grahamwhaley/DSPham/(threads)

Thread 1 (2021-02-15):

FIR filter co-efficients are 'non-optimal' - may need 'normalisation'

grahamwhaley, 2021-02-15:
Whilst working on some other experimentation, I noticed that the auto-generated FIR filter co-efficients for the bandpass filters seem to introduce a lot of attenuation, and are probably not 'optimal' for the required operation. That is no real surprise, as they are generated by a quick dynamic piece of code, and calculating optimal FIR coefficients is compute intensive.

The FIR filters happen early in the chain, which means later stages are probably not getting as 'full' a bitwidth signal as they should. This probably affects their performance.

I have some experimental code already that tries to measure the gain of the coefficients at their 'centre peak' intended frequency. Let's see if that improves anything.

(If you want to look at this etc., probably best ask me first so we don't duplicate)

Closed 2021-02-16.

Thread 2 (2021-02-16):

Decimate audio to improve NR

grahamwhaley, 2021-02-16:
Some of the NR reduction algos, such as the Spectral (possibly the best one), work on 'bins', splitting the audio into 'bins' and then selecting which ones have audio in them or not etc.
Currently (v1.0) we run the audio path at a full 44kHz sample rate, which is 'wasteful', as we are normally only interested in the audio part, which is probably upto 3.5kHz max.

If we decimate the audio path by 4, that takes us down to ~11kHz, so an audio bandwidth of ~5.5kHz. That will still leave us with plenty of 'space' for normal audio, and even an OK bandwidth for AM SWL. It will hopefully allow the NR systems to 'focus' more finely on the actual audio, and thus hopefully do an even better job of sorting out the noise from the useful sounds.

Try it out...

Closed 2021-02-16.

Thread 5 (2021-02-18):

Compiling DSPham.ini

codehopper199, 2021-02-18:
Hello Graham,
Very interested in your Radcom article as I have been trying to improve the audio on my IC7300 to get rid of some of noise on the output. I am not a programmer so could do with a bit of help if that is possible.
I am trying to compile DSPham.ino but it fails every time. I believe I have all the necessary files within my arduino IDE but it always comes back with an error as below where it cannot find global.h
Any help would be much appreciated.
Rod G0IYQ

Arduino: 1.8.13 (Windows 10), TD: 1.53, Board: "Teensy 4.0, Serial, 600 MHz, Faster, US English"

C:\Program Files (x86)\Arduino\arduino-builder -dump-prefs -logger=machine -hardware C:\Program Files (x86)\Arduino\hardware -tools C:\Program Files (x86)\Arduino\tools-builder -tools C:\Program Files (x86)\Arduino\hardware\tools\avr -built-in-libraries C:\Program Files (x86)\Arduino\libraries -libraries C:\Users\rodmi\Documents\Arduino\libraries -fqbn=teensy:avr:teensy40:usb=serial,speed=600,opt=o2std,keys=en-us -ide-version=10813 -build-path C:\Users\rodmi\AppData\Local\Temp\arduino_build_958171 -warnings=none -build-cache C:\Users\rodmi\AppData\Local\Temp\arduino_cache_775077 -verbose C:\Users\rodmi\AppData\Local\Temp\untitled2054921278.tmp\sketch_feb18a\sketch_feb18a.ino

C:\Program Files (x86)\Arduino\arduino-builder -compile -logger=machine -hardware C:\Program Files (x86)\Arduino\hardware -tools C:\Program Files (x86)\Arduino\tools-builder -tools C:\Program Files (x86)\Arduino\hardware\tools\avr -built-in-libraries C:\Program Files (x86)\Arduino\libraries -libraries C:\Users\rodmi\Documents\Arduino\libraries -fqbn=teensy:avr:teensy40:usb=serial,speed=600,opt=o2std,keys=en-us -ide-version=10813 -build-path C:\Users\rodmi\AppData\Local\Temp\arduino_build_958171 -warnings=none -build-cache C:\Users\rodmi\AppData\Local\Temp\arduino_cache_775077 -verbose C:\Users\rodmi\AppData\Local\Temp\untitled2054921278.tmp\sketch_feb18a\sketch_feb18a.ino

Using board 'teensy40' from platform in folder: C:\Program Files (x86)\Arduino\hardware\teensy\avr

Using core 'teensy4' from platform in folder: C:\Program Files (x86)\Arduino\hardware\teensy\avr

Detecting libraries used...

"C:\\Program Files (x86)\\Arduino\\hardware\\teensy/../tools/arm/bin/arm-none-eabi-g++" -E -CC -x c++ -w -g -Wall -ffunction-sections -fdata-sections -nostdlib -std=gnu++14 -fno-exceptions -fpermissive -fno-rtti -fno-threadsafe-statics -felide-constructors -Wno-error=narrowing -mthumb -mcpu=cortex-m7 -mfloat-abi=hard -mfpu=fpv5-d16 -D__IMXRT1062__ -DTEENSYDUINO=153 -DARDUINO=10813 -DARDUINO_TEENSY40 -DF_CPU=600000000 -DUSB_SERIAL -DLAYOUT_US_ENGLISH "-IC:\\Program Files (x86)\\Arduino\\hardware\\teensy\\avr\\cores\\teensy4" "C:\\Users\\rodmi\\AppData\\Local\\Temp\\arduino_build_958171\\sketch\\sketch_feb18a.ino.cpp" -o nul -DARDUINO_LIB_DISCOVERY_PHASE

Alternatives for Audio.h: [Audio@1.3]

ResolveLibrary(Audio.h)

  -> candidates: [Audio@1.3]

"C:\\Program Files (x86)\\Arduino\\hardware\\teensy/../tools/arm/bin/arm-none-eabi-g++" -E -CC -x c++ -w -g -Wall -ffunction-sections -fdata-sections -nostdlib -std=gnu++14 -fno-exceptions -fpermissive -fno-rtti -fno-threadsafe-statics -felide-constructors -Wno-error=narrowing -mthumb -mcpu=cortex-m7 -mfloat-abi=hard -mfpu=fpv5-d16 -D__IMXRT1062__ -DTEENSYDUINO=153 -DARDUINO=10813 -DARDUINO_TEENSY40 -DF_CPU=600000000 -DUSB_SERIAL -DLAYOUT_US_ENGLISH "-IC:\\Program Files (x86)\\Arduino\\hardware\\teensy\\avr\\cores\\teensy4" "-IC:\\Program Files (x86)\\Arduino\\hardware\\teensy\\avr\\libraries\\Audio" "C:\\Users\\rodmi\\AppData\\Local\\Temp\\arduino_build_958171\\sketch\\sketch_feb18a.ino.cpp" -o nul -DARDUINO_LIB_DISCOVERY_PHASE

Alternatives for SPI.h: [SPI@1.0]

ResolveLibrary(SPI.h)

  -> candidates: [SPI@1.0]

"C:\\Program Files (x86)\\Arduino\\hardware\\teensy/../tools/arm/bin/arm-none-eabi-g++" -E -CC -x c++ -w -g -Wall -ffunction-sections -fdata-sections -nostdlib -std=gnu++14 -fno-exceptions -fpermissive -fno-rtti -fno-threadsafe-statics -felide-constructors -Wno-error=narrowing -mthumb -mcpu=cortex-m7 -mfloat-abi=hard -mfpu=fpv5-d16 -D__IMXRT1062__ -DTEENSYDUINO=153 -DARDUINO=10813 -DARDUINO_TEENSY40 -DF_CPU=600000000 -DUSB_SERIAL -DLAYOUT_US_ENGLISH "-IC:\\Program Files (x86)\\Arduino\\hardware\\teensy\\avr\\cores\\teensy4" "-IC:\\Program Files (x86)\\Arduino\\hardware\\teensy\\avr\\libraries\\Audio" "-IC:\\Program Files (x86)\\Arduino\\hardware\\teensy\\avr\\libraries\\SPI" "C:\\Users\\rodmi\\AppData\\Local\\Temp\\arduino_build_958171\\sketch\\sketch_feb18a.ino.cpp" -o nul -DARDUINO_LIB_DISCOVERY_PHASE

Alternatives for SD.h: [SD@1.2.4 SD@1.2.2]

ResolveLibrary(SD.h)

  -> candidates: [SD@1.2.4 SD@1.2.2]

"C:\\Program Files (x86)\\Arduino\\hardware\\teensy/../tools/arm/bin/arm-none-eabi-g++" -E -CC -x c++ -w -g -Wall -ffunction-sections -fdata-sections -nostdlib -std=gnu++14 -fno-exceptions -fpermissive -fno-rtti -fno-threadsafe-statics -felide-constructors -Wno-error=narrowing -mthumb -mcpu=cortex-m7 -mfloat-abi=hard -mfpu=fpv5-d16 -D__IMXRT1062__ -DTEENSYDUINO=153 -DARDUINO=10813 -DARDUINO_TEENSY40 -DF_CPU=600000000 -DUSB_SERIAL -DLAYOUT_US_ENGLISH "-IC:\\Program Files (x86)\\Arduino\\hardware\\teensy\\avr\\cores\\teensy4" "-IC:\\Program Files (x86)\\Arduino\\hardware\\teensy\\avr\\libraries\\Audio" "-IC:\\Program Files (x86)\\Arduino\\hardware\\teensy\\avr\\libraries\\SPI" "-IC:\\Program Files (x86)\\Arduino\\hardware\\teensy\\avr\\libraries\\SD" "C:\\Users\\rodmi\\AppData\\Local\\Temp\\arduino_build_958171\\sketch\\sketch_feb18a.ino.cpp" -o nul -DARDUINO_LIB_DISCOVERY_PHASE

Alternatives for SerialFlash.h: [SerialFlash@0.5]

ResolveLibrary(SerialFlash.h)

  -> candidates: [SerialFlash@0.5]

"C:\\Program Files (x86)\\Arduino\\hardware\\teensy/../tools/arm/bin/arm-none-eabi-g++" -E -CC -x c++ -w -g -Wall -ffunction-sections -fdata-sections -nostdlib -std=gnu++14 -fno-exceptions -fpermissive -fno-rtti -fno-threadsafe-statics -felide-constructors -Wno-error=narrowing -mthumb -mcpu=cortex-m7 -mfloat-abi=hard -mfpu=fpv5-d16 -D__IMXRT1062__ -DTEENSYDUINO=153 -DARDUINO=10813 -DARDUINO_TEENSY40 -DF_CPU=600000000 -DUSB_SERIAL -DLAYOUT_US_ENGLISH "-IC:\\Program Files (x86)\\Arduino\\hardware\\teensy\\avr\\cores\\teensy4" "-IC:\\Program Files (x86)\\Arduino\\hardware\\teensy\\avr\\libraries\\Audio" "-IC:\\Program Files (x86)\\Arduino\\hardware\\teensy\\avr\\libraries\\SPI" "-IC:\\Program Files (x86)\\Arduino\\hardware\\teensy\\avr\\libraries\\SD" "-IC:\\Program Files (x86)\\Arduino\\hardware\\teensy\\avr\\libraries\\SerialFlash" "C:\\Users\\rodmi\\AppData\\Local\\Temp\\arduino_build_958171\\sketch\\sketch_feb18a.ino.cpp" -o nul -DARDUINO_LIB_DISCOVERY_PHASE

Alternatives for Wire.h: [Wire@1.0]

ResolveLibrary(Wire.h)

  -> candidates: [Wire@1.0]

"C:\\Program Files (x86)\\Arduino\\hardware\\teensy/../tools/arm/bin/arm-none-eabi-g++" -E -CC -x c++ -w -g -Wall -ffunction-sections -fdata-sections -nostdlib -std=gnu++14 -fno-exceptions -fpermissive -fno-rtti -fno-threadsafe-statics -felide-constructors -Wno-error=narrowing -mthumb -mcpu=cortex-m7 -mfloat-abi=hard -mfpu=fpv5-d16 -D__IMXRT1062__ -DTEENSYDUINO=153 -DARDUINO=10813 -DARDUINO_TEENSY40 -DF_CPU=600000000 -DUSB_SERIAL -DLAYOUT_US_ENGLISH "-IC:\\Program Files (x86)\\Arduino\\hardware\\teensy\\avr\\cores\\teensy4" "-IC:\\Program Files (x86)\\Arduino\\hardware\\teensy\\avr\\libraries\\Audio" "-IC:\\Program Files (x86)\\Arduino\\hardware\\teensy\\avr\\libraries\\SPI" "-IC:\\Program Files (x86)\\Arduino\\hardware\\teensy\\avr\\libraries\\SD" "-IC:\\Program Files (x86)\\Arduino\\hardware\\teensy\\avr\\libraries\\SerialFlash" "-IC:\\Program Files (x86)\\Arduino\\hardware\\teensy\\avr\\libraries\\Wire" "C:\\Users\\rodmi\\AppData\\Local\\Temp\\arduino_build_958171\\sketch\\sketch_feb18a.ino.cpp" -o nul -DARDUINO_LIB_DISCOVERY_PHASE

Alternatives for Encoder.h: [Encoder@1.4.1]

ResolveLibrary(Encoder.h)

  -> candidates: [Encoder@1.4.1]

"C:\\Program Files (x86)\\Arduino\\hardware\\teensy/../tools/arm/bin/arm-none-eabi-g++" -E -CC -x c++ -w -g -Wall -ffunction-sections -fdata-sections -nostdlib -std=gnu++14 -fno-exceptions -fpermissive -fno-rtti -fno-threadsafe-statics -felide-constructors -Wno-error=narrowing -mthumb -mcpu=cortex-m7 -mfloat-abi=hard -mfpu=fpv5-d16 -D__IMXRT1062__ -DTEENSYDUINO=153 -DARDUINO=10813 -DARDUINO_TEENSY40 -DF_CPU=600000000 -DUSB_SERIAL -DLAYOUT_US_ENGLISH "-IC:\\Program Files (x86)\\Arduino\\hardware\\teensy\\avr\\cores\\teensy4" "-IC:\\Program Files (x86)\\Arduino\\hardware\\teensy\\avr\\libraries\\Audio" "-IC:\\Program Files (x86)\\Arduino\\hardware\\teensy\\avr\\libraries\\SPI" "-IC:\\Program Files (x86)\\Arduino\\hardware\\teensy\\avr\\libraries\\SD" "-IC:\\Program Files (x86)\\Arduino\\hardware\\teensy\\avr\\libraries\\SerialFlash" "-IC:\\Program Files (x86)\\Arduino\\hardware\\teensy\\avr\\libraries\\Wire" "-IC:\\Program Files (x86)\\Arduino\\hardware\\teensy\\avr\\libraries\\Encoder" "C:\\Users\\rodmi\\AppData\\Local\\Temp\\arduino_build_958171\\sketch\\sketch_feb18a.ino.cpp" -o nul -DARDUINO_LIB_DISCOVERY_PHASE

Alternatives for global.h: []

ResolveLibrary(global.h)C:\Users\rodmi\AppData\Local\Temp\untitled2054921278.tmp\sketch_feb18a\DSPham.ino:7:20: fatal error: global.h: No such file or directory

  -> candidates: []

compilation terminated.

Multiple libraries were found for "SD.h"

 Used: C:\Program Files (x86)\Arduino\hardware\teensy\avr\libraries\SD

 Not used: C:\Program Files (x86)\Arduino\libraries\SD

Using library Audio at version 1.3 in folder: C:\Program Files (x86)\Arduino\hardware\teensy\avr\libraries\Audio

Using library SPI at version 1.0 in folder: C:\Program Files (x86)\Arduino\hardware\teensy\avr\libraries\SPI

Using library SD at version 1.2.2 in folder: C:\Program Files (x86)\Arduino\hardware\teensy\avr\libraries\SD

Using library SerialFlash at version 0.5 in folder: C:\Program Files (x86)\Arduino\hardware\teensy\avr\libraries\SerialFlash

Using library Wire at version 1.0 in folder: C:\Program Files (x86)\Arduino\hardware\teensy\avr\libraries\Wire

Using library Encoder at version 1.4.1 in folder: C:\Program Files (x86)\Arduino\hardware\teensy\avr\libraries\Encoder

Error compiling for board Teensy 4.0.

grahamwhaley, 2021-02-19:
Hi Rod,
 thanks for opening the Issue. Nothing obvious leaps out at me, but I'll note a few things and we can try and work our way through it.

First, it looks like you are building on Windows. That should be fine, but I'll note that I build on Linux, and don't have a Windows machine to test on. I'm hoping that is not the problem.

The two primary things I'd expect to be candidates for the problem would be:
 - paths
 - capitalisation

Can I ask, how did you copy the files from github, and what path have you placed them in on your computer? You pretty much need all the files in the top level directory. By far the best way to get the files is by `git` cloning the repository - there are github instructions [here](https://docs.github.com/en/github/creating-cloning-and-archiving-repositories/cloning-a-repository).  Alternatively, you can I believe grab a zip or tar.gz file of one of the tags from https://github.com/grahamwhaley/DSPham/tags, and unzip that locally on your machine.

Make sure your code is in a directory with the same name as the `.ino` file - so `DSPham` in this case. If not then I suspect the Arduino IDE would not even have opened the `.ino` though, so that probably is not your problem.

Let me know how you grabbed the code and where it is placed (maybe a `pwd` and an `dir` to show the contents), and we'll go from there.

grahamwhaley, 2021-02-19:
Small update - I just grabbed the `.tar.gz` from the v1.0 tag. I found that it unzipped into a folder called `DSPham-1.0` (gee, thanks github ;-) ). That has to be renamed to plain `DSPham` in order to then work in the IDE.

grahamwhaley, 2021-02-20:
Hi @codehopper199 - re: our recent email thread, I think you are now building OK, yes?

To summarise, the key items we found were:
 - github zip/tar files place the project in a `DSPham-xxx` folder, but to build in the Arduino IDE the files *must* be in a folder called just `DSPham`
 - The Teensy board config in the Arduino IDE must be set to include the 'Audio' component - I use `Serial+MIDI+Audio`, so I'd generally recommend that.

Correct?

I've got a documentation change ready to merge detailing the first point. Let me know if you are OK with building now, and I'll update the docs and (you or I) can close this issue. Thanks!

codehopper199, 2021-02-20:
Yes Graham, all correct, will you close the issues please.

Regards,
Rod G0IYQ

Sent from my iPad

On 20 Feb 2021, at 16:12, Graham Whaley <notifications@github.com<mailto:notifications@github.com>> wrote:

Hi @codehopper199<https://github.com/codehopper199> - re: our recent email thread, I think you are now building OK, yes?

To summarise, the key items we found were:

  *   github zip/tar files place the project in a DSPham-xxx folder, but to build in the Arduino IDE the files must be in a folder called just DSPham
  *   The Teensy board config in the Arduino IDE must be set to include the 'Audio' component - I use Serial+MIDI+Audio, so I'd generally recommend that.

Correct?

I've got a documentation change ready to merge detailing the first point. Let me know if you are OK with building now, and I'll update the docs and (you or I) can close this issue. Thanks!

—
You are receiving this because you were mentioned.
Reply to this email directly, view it on GitHub<https://github.com/grahamwhaley/DSPham/issues/5#issuecomment-782707359>, or unsubscribe<https://github.com/notifications/unsubscribe-auth/AS4ZIV3RUT4N2TP23PGARVDS77NPDANCNFSM4X2TJJUA>.

Closed 2021-02-21.

Thread 6 (2021-02-19):

Changing versions prevents slot edits being loaded

grahamwhaley, 2021-02-19:
I noticed that slot saving was not taking effect after a reboot.
It turns out that if you have changed firmware versions, as we have a version dependant fingerprint in the eeprom settings, the firmware will 'default' due to an eeprom version mismatch, and load the default settings on boot - thus, skipping loading any setting changes that are stored in the eeprom.
So, the settings you edit do afaict get saved in the eeprom, they just won't get reloaded if there is an eeprom version mismatch.
The quick workaround/fix is to do a settings factory reset, which should rewrite the defaults of the current firmware into the eeprom (including the fingerprint), and then you should be able to save/load again.

If we were to make this 'really nice', we'd probably notice the eeprom version did not match the firmware, and in the settings menu 'persuade' the user they need to do a factory reset of the settings. We probably should not auot-reset the eeprom - take the 'path of least surprise' for the user.

Thread 7 (2021-02-19):

editing settings slot is 'awkward' if a decoder is active

grahamwhaley, 2021-02-19:
It feels like if a decoder (CW) is active and decoder whilst you are in the 'edit slot name' text editing menu, things get a bit weird on the screen, as the cursor jumps around to the top line, when it should be on the edit text.

I suspect one of two things:

1) we are still calling `setCursor`, even though the decode 'display' is off, as we are in the menu
2) something is a little screwy with my RGB LCD integration into the neu-rah menu library.

I suspect (1), but [the code](https://github.com/grahamwhaley/DSPham/blob/master/morseGen.cpp#L25-L28)
looks good on a cursory glance:

```cpp
  if (display ) {
    lcd.setCursor(0, 0);
    lcd.print(buf);
  }
```

Closed 2021-11-08.

Thread 18 (2021-03-17):

Document the display values

grahamwhaley, 2021-03-17:
We cover the display layout in the README, but we don't explain what the values of each entry mean. It would help users if we documented this better. Here is a very quick rundown for starters:

## top line
 When not in CW mode, the top line displays the current active settings slot (00-10), and the name of the slot (`SSB` etc, or `Empty` if the slot contains no settings.
 When in CW mode, the decoded CW scrolls across the top line, from right to left.

## Status line
The status line is always displayed, and the each status item/position has a fixed function. They are, in order from left to right:

### Input volume

Shows 'bars' indicating the input signal volume level. A single '.' is the lowest level. Four 'bars' is a high level. If input clipping (volume too high) is detected then an `!` will appear for 0.5s.

### Bandpass filter

Indicates which bandpass filter is active. Values are:

- `->` passthru (not actually off, but 'broadbanded')
- `S` SSB
- `C` CW
- `A` AM
- `F` FM

### Noise blanker

Shows if the noise blanker is on or off. Shows `-` for off, and an 'impulse' type character (similar to `~` or a slanted *`N`*) when active.

### Auto notch

Shows if the noise blaner is enabled or not. Shows `-` when it is off, and a stylised `V` when it is on.

### AGC mode

Shows which, if any, AGC (like) method is in use. Values are:

- `-` Off (no AGC)
- `T` software 'tracking' mode (tries to match the peak output volume with the peak input volume)
- `5` SGTL5000 hardware AGC mode (the AGC in the audio codec hardware chip). Is not an AGC as you might think of it - there is not minimum level squelch type clip. Fundamentally it will try to maintain an even maximum volume without clipping.

### Noise reduction

Shows which noise reduction algorithm is active. Values are:

- `BYP` complete bypass mode (may not be possible to configure currently)
- `Off` noise reduction is turned off
- `LMS` LMS reduction mode
- `Kim` Kim reduction mode
- `fnr` fnr reduction mode
- `fnA` fnrA reduction mode
- `Spc` Spectral reduction mode
- `LLM` LLMS reduction mode

### CPU utilisation
Shows a rough estimate of the amount of CPU time that is being consumed doing the processing. Generally a fairly low number.

### CW tuning aid
A rough guide to help tune in the CW decoder. The CW decoder 'listens' to the centre frequency defined for the active bandpass filter. The tuning aid listens for the 'loudest' tone in the signal, and shows one of five symbols to reflect how the detected tone relates to the bandpass:

- `<<` Tone much too low
- `<` Tone too low
- `x` Tone matched
- `>` Tone too high
- `>>` Tone much too high

### CW WPM

Shows the current detected CW word per minute speed as detected by the decoder that is active. Note, if using the Bayesian decoder there can be some delay between signals being heard and the WPM and decoded characters being printed.

Thread 19 (2021-06-27):

Settings: save slot does not save name

grahamwhaley, 2021-06-27:
There seem to be at least a couple of things wrong with the 'save settings'.

I was trying to 'clone' an existing slot and change the active NR. I selected CW (slot 5), set the slot number in the settings menu and set the name, and changed the NR algo from none to LLMS. Then I saved into slot7. When then re-selecting slot7, the name was blank and the NR was not set...

Looking at the code, it seems that `saveSettings()` does not save the name, which looks to be a bug. Should be an easy fix?

I've not worked out why the NR did not get set - that might require some actual debug...

grahamwhaley, 2021-11-08:
Looks like this is not an issue. Although the code did appear not to copy over the name to save, that is because the name was already in the slot from when it was loaded or edited.

I probably 'saw' the issue whilst having a version mismatch during development, which causes name save/load issues.

I've added a comment to the code noting that the name field is valid and saved.

Closed 2021-11-08.

Thread 23 (2022-04-21):

20 memory slots and squelch/gate

Roturbo, 2022-04-21:
Hello Graham, is it possible to increase the slots to 20 ?

How about a squelch/gate to make noise floor complete silent and only voice open the audio ?

Just ideas to make it better.

Tanks for your amazing project.

grahamwhaley, 2022-04-21:
Hi @Roturbo - thanks for your questions :-)

- The memory slots - if I remember correctly, the number of slots is dictated by the amount of eeprom space available on the Teensy board. The Teensy 4.0 I used [only has 1080 bytes of emulated eeprom](https://www.pjrc.com/teensy/techspecs.html) - not an awful lot of space. You might be able to squeeze few more slots if you can manage to reduce or pack the memory slot structures closer, but I suspect not many. To see how much space is currently used you can add a print statement to the code to see how big the `factory_default_settings` structure is: https://github.com/grahamwhaley/DSPham/blob/master/settings.cpp#L24

    Alternatively, if you used maybe the Teensy 4.1 instead, it has 4284 bytes of eeprom, so you should be able to fit the 20 slots in :-)

- On the noise gate - I think it's possible to add one. There is a teensy audio library example over in the OpenAudio library that has a noise gate: https://github.com/chipaudette/OpenAudio_ArduinoLibrary/blob/master/AudioEffectNoiseGate_F32.h

    As far as I know, the OpenAudio library is a 'drop in' library that builds on top of the original Audio Library, so it should not be hard to either port that noise gate code across, or to start using the OpenAudio library with DSPham, and it should already build and work I think... but, I've not tried it.

Personally, I have no plans (or right now time) to try either of these out, but if you are code capable and want to give this a try then I will of course give you any help, pointers and advice I can.

Let me know if you have or are building a DSPham - I'm always interested if people build one and how it performs etc.

Roturbo, 2022-04-21:
Hi Graham,   i know very little about programing, i was able to increase the slots to 20 and disable the Morse menus,
but i get a NAN, (not a number) on the Volume menu, it was a basic solution.

I have notice OpenAudio library before, the problem is to insert it on the code and creating a menu to increase or decrease the
gate levels, or to make it "smart" in a way to detect were there is no voice (flat noise) and were the voice enters, transitions
must be  smooth, the delay must be adjustable etc.

And yes, i have build a DSPham, it works amazing in my case, i can tell you it is not perfect, it needs much RF filtering, not only
the RF that comes from the radio, but also the clocks and oscillators from Teensy and the audio board, i have one SDR connected
to the IF of my radio,, and i can see very strong signals on 3mhz, 10mhz etc, with a small antenna that signals go over 2 meters,,
sometimes the signals oscillate depending on the voice levels,, and as you imagine, were that signals beat there is no way to
listening the stations, this is the 600mhz Teensy working inside a aluminum case not free air.

In SSB many stations come mixed with band noise, and some of them don´t have good audio, the DSPham can clear the
noise and make the audio more linear, smooth and clear, with low noise radios it is like FM,, no noise, only the voice is
coming out of the speaker, if there is some noise on the band or with radios that have more noise,, than on moments
were no one is talking you get like drooping water noise (bubbling) as many other DSP, and here is the reason for the squelch/gate.

I´m going to read more about the Audio Library, maybe i can add it to the code and make it work.

Tanks for your replay, i will keep you informed.

grahamwhaley, 2022-04-22:
Hi @Roturbo .
 Heh - the NAN for the volume is probably because when you increased the slots to 20, it made the `eedata` structure too big. As the `volume` parameter in that structure is near the end of the structure, it probably 'fell off' the end of the eeprom space, so when the unit boots it reads back garbage, and translates that to a NAN.

The RF filtering and noise interference - yes, I had some of that on my initial build. Most of mine was coming from the regulator though - once I added more capacitor filtering around my 7805 a lot of my noise disappeared - but, that may not be your issue.

The trick is going to be figuring out how the noise is getting into the DSPham - is it coming down the audio leads, or the power cable or USB lead. When using my DSPham with my Xiegu G90 I did put an audio isolating transformer between the G90 and the DSPham - something like https://www.aliexpress.com/item/1005001604545947.html for example. The other thing you can try is wrapping the cables through ferrites or using clip on ferrites. This is not something I can fix in the software ;-)

Also, watch out for the input volume - if it is too loud for the DSPham then it starts to 'clip', and the audio starts to crackle. I added the `!` warning symbol on the volume display to try and indicate if this is happening.

I'm really glad the DSPham is working for you! I'm going to presume you are using the 'spectral' noise reduction. I'm currently porting that code over to the [open audio library](https://github.com/chipaudette/OpenAudio_ArduinoLibrary/issues/12). One thing you could try to reduce the 'watery' effect during silence is to increase the `NR_alpha` value. In DSPham it is default of 0.95 - but whilst working on the OpenAudio port I find that a value of 0.98 is less watery and does not impact the noise reduction too much. You should be able to adjust this through the menu (it is called Kim Alpha I think - as the NR_alpha variable is shared between the Kim and Spectral noise reduction code), or you can just try changing the default in the code and reflashing/resetting your unit.

I'll be offline for a week or so now - so if I don't respond right away it's not that I'm ignoring you - I'll check when I get back to my desk :-)

grahamwhaley, 2022-05-06:
Hi @Roturbo . Well, I'm back at my desk, so can try to answer any further questions you might have.

I did have a thought - which I'll write here in case it is useful to you or possibly others in the future....

If you do add the squelch function, then there are two 'functions' on the rotary encoder which I think are not currently used in DSPham that could be tied to the squelch to make it easier to access from the 'normal' mode, and avoid having to always go into the menu...

 - long press
 - double click

Right now, when not in menu mode, I think we only use:
 - rotate - is change function
 - click - is enter menu

so you could have a long press or a double click enter a new mode - 'adjust squelch' maybe. Just a thought. It would require some programming around the `Encoder enc1` object in the main `.ino` file to detect the long press or double click, and then some extra code inside the `if (in_menu){...} else {` code to handle the squelch.

Roturbo, 2022-05-08:
Hello Graham.

The noise is more interference sometimes from the radio in TX (RFI) other times is the
DSP that produce harmonics that interfere on some low frequencies.

I manage to attenuate the Teensy harmonics using an RC, on the 5v input i use a 3 ohm
resistor and next a 1000uF/6v capacitor, some ferrites also help, but there are strong
signals that can pass on audio amplifier to the speaker, all can be cleaned, we
just need to see were they are.

The clipping i have it controlled, i manage to add a small audio amplifier inside the box,
also made a true Bypass for real comparing of original and filtered audio.

Let me tell you, the encoder (the ones from Grove) i have to struggle to make it work,
before the menu it was more or less working, but inside menu i have to change the code
because one step make it advance 2 places on the menu, if i move very slow i was able
to see one more option.

I have made some changes on code so now i can go to 0.99 on the NR-Alpha, the watery effect
it is not present all the time, it depends on radio filter and noise of the band, it is really
noticeable if no one is talking, that's were the idea of the audio squelch call my attention.

About your last message.

Yes, i know about the long press and double click, the double click inside the menu is the BACK
function one level up, but as you say, in normal mode it does nothing, so it is a good idea to
use that function, double click enter the squelch menu, but that is over my knowledge.

My programming skills are very low, i take some time reading the web to find the code to
make the audioConnection work on USB on the 2 directions, now i can pass the cleaned audio from the
DSP to PC and record it, or i can send the audio from PC over USB and use the DSP as a filter.

I was also able to make a second OLED 1.3" 128x64 LCD work in parallel because it uses different
address on I2C, but i don´t know how to convert all the menus etc for the OLED, also intend to
use FFT spectrum analyzer but the know how is missing, so i remove it.

I really don´t plan to make a fork of your work, but i want to work with you to make
this DSP better, later i can send you more details about my building, and some audio
samples to verify the quality.

And thanks, your DSP can remove most of the annoying noise from most radios,
and the auto notch filter works just as well.

Roturbo, 2022-06-20:
Hi Graham, i leave here some pictures of my first unit made in a small alu box.

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

Regards

grahamwhaley, 2022-06-21:
Hi @Roturbo - thanks for the pictures! That looks like a nice compact unit - and you have squeezed in some more features - I presume at least one of the extra rotary controls is for volume, and the switch is for power? Looking nice :-)

Did you manage to make your rotary encoder function correctly, and not 'skip' and do 'double steps'? My guess is that your encoder has a different number of ticks-per-detent than mine. Somebody else saw this before (even though both encoders were labelled/sold as ky-040) - there is a note on the home page about the code you have to change to cater for different encoders - if you've not seen it, its in the section https://github.com/grahamwhaley/DSPham#hardware-choices . If you have issues with that, ping me and I'll stare at the code again. I think a change would need to be made in two places - one for the menu system and one for the 'default' screen - they use different encoder code I'm afraid.

Just for reference, I don't know if you saw, but the Spectral Noise code got merged into the open audio library :-) https://github.com/chipaudette/OpenAudio_ArduinoLibrary/pull/13

Roturbo, 2022-06-22:
Hello Graham,

This was in fact a very small case, i have add the VU leds later,,, the left button  is to control the input signal , 5 or 10K,
 on center is the BYPASS switch, this way i´m able to change from normal with noise to DSP audio,, than
on the right, it is a cheap 3w amplifier that also have included a switch, this i use to power also the teensy,

Later i have to add a 3ohm resistor and a big capacitor as a RC filter to avoid signals coming from the Teensy
and enter the audio amplifier,, this signals also go out the box from the speaker line.

The rotary problem yes i have face it 2 times, at first with that encoder, and later again with other encoders
that i buy from different place that were also different, and you are correct, i have to change it in 2 places,
it starts to work better, but never perfect, i have use the same encoders with DDS and other projects and
they are working perfect, no missing or double steeps,, the changes i made in code i have to use it not
too fast or i start to have missing stpes.

About the Noise Gate, i just read the link now, tanks to tell me, at start i have many problems like @NickTheVic,,
with DSPHAM, it was my first challenge on this project, get the correct files to make it compile.

On that link you are talking about change the filter from 100-3600 to 300-2800, from my experience this
should always be and adjustable option, i notice that the "watery" is the same if i use a 50-4500 filter, and
some stations on SSB use larger filters to transmit better audio quality, that you will not ear if is not
possible to adjust that filter.

But my knowledge is very limited on coding, i can change what is already made and copy parts of code from
other projects and use it, and i would love to add that adjustable "GATE" or "virtual squelch" to silence all noise
if there is no audio voice detected,, maybe in future you can give me some help, i notice on that link that
you don´t have time now.

I read about the syllabic rate detector module, but did´t find any code based on this type
of voice detection.   http://www.naval.com/vos/

I have made some changes inside the code that i need to find to tell you what i have made,
i think it was one VAR related to Alpha were it have 0.99 i change it to 0.998, than it can go
to 1 without removing all the audio,, but voice is not totally clear,, and yes, 0.99 is the less
noise and "watery" in my case, it depends on radio noise.

Other option that i struggle to add was the UPDATE function without pressing the teensy button,
a simple routine that do the same inside the menus, this way there is no need to open the case
if i want to enter that mode.

Just remember, KIWISDR is also using spectra and LMS filters, but spectra is the best.

i will be out for some days, but i will try to post pictures of the V2, i have build  3 units for my friends,
later i have build 10 units of the final V3 for the other ones that also like it,, but will not build more, the material
cost more than 100€,, than there is CNC cutting, printing the labels and some hours of work that never end.

For the moment i only think in make the software better with that gate to remove the "silent" parts
were there is no audio and the watery starts rising,, **(SSB squelch), we may also think about it as
an inverted VOX because it have similar function.**

Regards,

grahamwhaley, 2022-06-28:
Hiya,

> The rotary problem yes i have face it 2 times, at first with that encoder, and later again with other encoders that i buy from different place that were also different, and you are correct, i have to change it in 2 places, it starts to work better, but never perfect, i have use the same encoders with DDS and other projects and they are working perfect, no missing or double steeps,, the changes i made in code i have to use it not too fast or i start to have missing stpes.

I'm going to guess you have the missing or double steps only in the default mode, and not inside the menus. The missing step problem is very likely as I implemented some very rudimentary 'debounce' code](https://github.com/grahamwhaley/DSPham/blob/master/DSPham.ino#L520-L523) :

```c
  const unsigned long debounce_gap = 250;  //ms
...

  if (enc_change != 0 )
      {
        // Are these clicks too close to the last set - if so, drop them to 'debounce'
        // We could also use a state filter to do this as per https://www.best-microcontroller-projects.com/rotary-encoder.html
        // state=(state<<1) | digitalRead(CLK_PIN) | 0xe000;
        if (ms > last_change + debounce_gap ) {
          if (enc_change > 0) {
```
So, if a 'click' turns up before 250ms is passed, it gets ignored. That's not idea I know, but it was a quick fix to a bouncy encoder problem. The 'real' solution is to write some better debouncing code there, or to use a better encoder library :-) The decoding library used inside the menu system seems fairly robust, so we could just copy what that does :-).

You could try reducing the 250ms timeout which should improve things maybe.

> Other option that i struggle to add was the UPDATE function without pressing the teensy button, a simple routine that do the same inside the menus, this way there is no need to open the case if i want to enter that mode.

afaik, as long as your teensy has booted and is connected to the USB, then the teensy loader should be able to reset and reflash it without you needing to press the button. I just tried that here (with a different Sketch, but on a Teensy 4.0), and it worked. Only if your teensy is crashing and not connecting to USB should you need to press the button I think. That is part of the reason I added an external 'program' button to my DSPham box (on the back), so I could reprogram it if I crashed or corrupted it during development, without having to take the lid off :-)

> i will be out for some days, but i will try to post pictures of the V2, i have build 3 units for my friends,
> later i have build 10 units of the final V3 for the other ones that also like it,, but will not build more, the material
> cost more than 100€,, than there is CNC cutting, printing the labels and some hours of work that never end.

**Wow** - you built **how many!!** :smile: That's amazing @Roturbo . I think that is by far the most anybody has built. I'm so glad it is working for you!

> For the moment i only think in make the software better with that gate to remove the "silent" parts were there is no audio and the watery starts rising,, **(SSB squelch), we may also think about it as an inverted VOX because it have similar function.**

Sure. I think there are two ways that might be done:

1) add 'automatic muting' to the spectral code, so that when the VAD code detects there is no voice it can mute the output
2) add a universal 'squelch' using the code from the OpenAudio library, which could then be used for all the NR modes.

I'm still not sure if/when I'll find time to look at that though :-(

Roturbo, 2022-07-03:
Hello again.

I did also have problems inside the menus, i remember that at start i have to turn the encoder very slowly,, it was like
the encoder was reading the half steps, than i change something that make it work better, still, with limited speed,
if i go faster the menus didn´t change.

> So, if a 'click' turns up before 250ms is passed, it gets ignored.

This was changed to 100ms,, but depends on type of encoder.

> That's not idea I know, but it was a quick fix to a bouncy encoder problem. The 'real' solution is to write some better debouncing code there, or to use a better encoder library :-) The decoding library used inside the menu system seems fairly robust, so we could just copy what that does :-).

https://github.com/gi1mic/DSP-Speaker-Filter/blob/master/code/GI1MIC-DSP-Filter.ino

Before your project i have build the one in the link,, with same encoders this one works fine, maybe
you can try that one, or any other that is not sensitive to different type of encoders.

> Wow - you built how many!! 😄 That's amazing @Roturbo . I think that is by far the most anybody has built. I'm so glad it is working for you!

I think that i have build 1 test unit, 3 for beta testers and 10 for friends that want to have a more comfortable time
in front of the radio,, and i´m done, now if anyone wants he have to buy the parts and build it.

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

The adjustments is always a must, in any of the cases we must be able to adjust the threshold, the rising and fallowing or maybe
make it work almost like and AGC,, slow med fast etc,, because in SSB there are many audio pauses, and it may become
annoying if the squelch is kicking in the wrong way on each audio pause.

> I'm still not sure if/when I'll find time to look at that though :-(

I will wait, and i will keep telling you the few things i have done,, for example, i have overclock the CPU,
it is running at 700Mhz,,

  Next is the V2,, with many mistakes to correct.

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
![3](https://user-images.githubusercontent.co
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
m/91867260/177026941-e6da8fb0-9ba9-4668-a07f-d67db0d71926.jpg)
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

Roturbo, 2022-07-18:
Hello Graham, next is the final version that i made, still have some mistakes but is better than previous one.

RXA and B are the inputs from 2 different radios, the upper switch chose the output direct from internal amplifier
to a speaker or Line Out to use external amplifier.

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

I will try to make some recording original and after DSP for comparing.

kabidey, 2023-01-20:
i have finally made one. works very well.
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

grahamwhaley, 2023-01-22:
Hi @kabidey - excellent! Ooh, with built in speakers and amplifiers! I'm glad it's working well for you!

Thread 24 (2022-07-16):

Audio IN to USB "in" ?

rhaamo, 2022-07-16:
I am trying to get the audio incoming into the DSP to be routed in the "in/mic" of the USB, but I think I am missing something.

I have tried adding:
```cpp
AudioOutputUSB           usb2;
...
AudioConnection          patchCord15(usb1, 0, usb2, 0);
AudioConnection          patchCord16(usb1, 0, usb2, 1);
```

Also with `Q_in_L` or `peak_amp` instead of `usb1` but nothing.

What can I be missing here ?

grahamwhaley, 2022-07-16:
Hi @rhaamo . Thanks for your question. To check, you are trying to take the audio being fed into DSPham, and direct it back out over USB to the computer, yes?

The code you posted looks OK to me. It should route the audio coming into the DSPham USB back out over the DSPham USB  back to the computer.

I should ask, how are you monitoring the audio on the computer end? This may be a silly question, but I think it is the first logical step. I don't know which operating system you are using, but I think you will need to open a system audio config dialog or an application and choose the Teensy Audio in device or make an 'audio pipe' in order to hear it?

I also presume you have a working DSPham hardware, and it boots and works normally? And you are feeding some audio into the DSPham to process? The DSPham itself make no noise without an input :smile:

Maybe a fist step is to check you can hear sound coming out over the Teensy USB. There is an example for instance [here](https://forum.pjrc.com/threads/60377-Monitoring-AudioOutputUSB-from-Teensy-4-0) on the teensy forum where a sine wave is fed directly out over USB - that would ensure the hardware and computer are set up OK to start with?

Then, if you want to monitor the audio into the DSPham, you might be better taking the feed from the `input_mixer`, which will then get you audio from both the USB and line-in inputs:

```c
AudioOutputUSB           usb2;
...
AudioConnection          patchCord15(input_mixer, 0, usb2, 0);
AudioConnection          patchCord16(input_mixer, 0, usb2, 1);
```

Or, the more obvious to me, is to feed the *processed* audio back over USB, like:

```c
AudioOutputUSB           usb2;
...
AudioConnection          patchCord15(peak_amp, 0, usb2, 0);
AudioConnection          patchCord16(peak_amp, 0, usb2, 1);
```

but it sounds like you tried that already.

I hope that helps? If you cannot get it to work, let me know, and I will see if I have time to test the code here. I do think having USB output on DSPham would be useful, as DSPham could then be used as an 'outboard USB DSP processor', without the need for a line in/out or headphones...

rhaamo, 2022-07-17:
Hello!

First yes I have a working DSPham, how it is wired is basically as an external loudspeaker with extras: 4 inputs mono selector to DSPham to an amplifier to a speaker/headphones.

The input of the DSPham is the headphones out of a xiegu g90, that part works, I can use the filters properly.

As the teensy usb/audio part, if I choose the Teensy as audio out on the computer, I can hear music through the teensy and speaker.

What I am interested in is doing:
```
TRX -> DSPham _> speaker
             \_> usb audio to computer
```

I think I did try `peak_amp`, I will retry a bit later and let you know.

And for how I monitor the audio on the computer, it was with fldigi (I wanted to decode some digimodes).

Roturbo, 2022-07-17:
Hello rhaamo and graham.

I have change my code in order to get audio out from the teensy, it means if i want the audio comes from the radio
to the teensy and is cleaned or bypass and goes to PC over USB, i just need to chose the micro input on PC and the
audio comes out of the speakers or i can pipe it to a virtual cable and using audio recorder software chose the same
virtual cable and start recording.

On my PC, if i chose the audio output as the teensy, than all the audio from my PC will go to USB and will come out
on the DSPham speaker, i can also clean it, change filters etc, or bypass.

Sometimes i use this to clean the audio from some websdr that i use all over the world, and i have success getting
a recorded files played on PC than goes to teensy to clean it and back to PC to record it again already processed,
this is a little more complex and requires virtual cables.

Don´t remember if i have to install some drivers win10, but teensy is detected as an USB audio IN/OUT.

Line 37
> AudioInputUSB            usb1;   // USB audio input from PC
AudioOutputUSB           usb2;  //                 **_-------------USB audio output to PC_**
AudioOutputI2S           i2s_out;
AudioInputI2S            i2s_in;
AudioConnection          patchCord15 (i2s_out, 0, usb2, 0);   //            **_-----------connection to audio output on USB_**`

on line 79
> //Wire up the peak detectors

AudioConnection          patchCord9(input_mixer, 0, input_peak_detector, 0);
AudioConnection          patchCord10(firfilter, 0, postfir_peak_detector, 0);
AudioConnection          patchCord11(peak_amp, 0, output_peak_detector, 0);
AudioConnection          patchCord12(Q_out_R, 0, toneDetect, 0);  //Should we do these after the peak amp?
AudioConnection          patchCord13(Q_out_R, 0, noteFreq, 0);    //Should we do these after the peak amp?
AudioConnection          patchCord114(peak_amp, 0, usb2, 0);    //           **_----------output to USB for audio on PC_**

These are the mods i have done, you can try it and report if it works for you.

Regards.

Roturbo, 2022-07-20:
Hi @grahamwhaley , it is like you say,, the redundant i think i forget to remove,

O was trying to record the audio and notice that one channel was empty,, it was mono,, so i add the code
as you say, but Audacity record with low audio level,, maybe there is a way to increase the audio output
from Teensy USB,, if you know it please tell me.

Tanks for your help.

Regards.

grahamwhaley, 2022-12-27:
Hi @rhaamo - just wondering if you ever got this to work? If so, shall we close this Issue? :-)

Thread 25 (2022-08-17):

Problem with Grove Display

SDupuie, 2022-08-17:
Graham,

I built up an Audio board with a Teensy 4.0 and hooked it up according to your schematic. I loaded the libraries and then compiled and uploaded the program. I am getting audio through the board and the encoder seems to be working (I can turn off the audio with a particular sequence of encoder manipulations), but I am not seeing any text on the display. The backlight is on. I am using the exact Grove RGB LCD specified in the documentation. I have the VCC for the display connected to the 3.3V output of the Teensy, GND connected to ground, and SDA and SCL connected according to the schematic. I have checked my wiring multiple times. The display I have says that it supports an input voltage of 3.3V or 5V. I thought maybe there was a problem with my compiled version of the firmware so I downloaded your .hex file and loaded it. I got the same results.

I could have a bad display, but I want to ask if you have any thoughts on what the problem might be.

Thanks,
Scott

grahamwhaley, 2022-08-17:
Hi @SDupuie . Thanks for posting the question.
I think the problem might be that VCC of the Grove LCD should be connected to the 5v line, not the 3v3. The LCD panel used on the Grove module itself is listed as being a 5v part in the datasheet - from the [grove page]() I found the datasheet [here]( https://files.seeedstudio.com/wiki/Grove_LCD_RGB_Backlight/res/JHD1313%20FP-RGB-1%201.4.pdf) - which shows VDD to be 4.5v - 5.5v (on page 8). I think the data lines will support inputs of 3.3v, but the power line itself (VDD) must still be 5v. The [RGB LED I2C controller](https://files.seeedstudio.com/wiki/Grove_LCD_RGB_Backlight/res/PCA9633.pdf) on the module however looks like it can operate from 2.3v to 5.5v, which is probably why the backlight is working.

Fingers crossed moving the VCC of the display to 5v will fix the problem! Let me know if that works, and I can update the documentation and maybe the schematic to make it clearer.

SDupuie, 2022-08-17:
Hi Graham,

Thanks, that was it. I was wondering if that was the issue, but I wasn't sure if the display had pull-ups on the I2C lines that would cause 5V to back feed to the Teensy. In retrospect, that should not be the case.

Thanks,
Scott

grahamwhaley, 2022-08-18:
Excellent @SDupuie :-) But, yes, I too worry a little about mixing the 5v and 3v3 parts. At least one builder has successfully used a level converter to avoid the risk - something I think like one of [these](https://shop.pimoroni.com/products/adafruit-4-channel-i2c-safe-bi-directional-logic-level-converter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). So, if it worries you, then that might be a path to pursue.

Out of interest, do you have any specific plans for DSPham? I'm always curious on how they get used :-)

If you are happy we've resolved the display issue for you then shall we close this ticket?

SDupuie, 2022-08-18:
Graham,

I may eventually replace the display with a 3.3V OLED, but I wanted to get the code up and running before attempting to do that.

I built DSPham because I want to play around with noise reduction algorithms and this seemed like a good platform to get started on. I find that even modern ham radios do not have very good NR (most are LMS).

Thanks,
Scott

Closed 2022-08-18.

Thread 26 (2022-12-24):

Need to use LiquidCrystal_I2C

kabidey, 2022-12-24:
Hi Graham, i am not good with modifying the codes, need the thing modified to display in 1602 I2C, i cannot do it. Please help.

grahamwhaley, 2022-12-24:
Hi @kabidey,
 if you can tell me which I2C screen you have then I might be able to help. As the screen I used (Grove) is already I2C, it might be not too difficult to make the changes.

Ideally your screen will be supported by the menu library I use:
https://github.com/neu-rah/ArduinoMenu

Merry Xmas!
 Graham (replying via email - hope it renders OK. I will have more time to look after xmas).

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

kabidey, 2022-12-24:
My display is the parallel 1602 lcd display with a I2C adapter soldered.

On Sun, Dec 25, 2022, 12:46 AM Graham Whaley ***@***.***>
wrote:

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

grahamwhaley, 2022-12-24:
Thanks @kabidey,

 I think you will probably want to use the ' • HD44780 I2C’ support from the F Malpartida's LCDs :
https://bitbucket.org/fmalpartida/new-liquidcrystal/wiki/Home

A very good first step will be to see if you can get the arduino menu examples working , for instance, for your screen probably try:

https://github.com/neu-rah/ArduinoMenu/tree/master/examples/LCD_Malpartida/I2C/I2C

If you get that working, you are probably 75% of the way to getting DSPham working on your display. The other thing you will need to modify in DSPham is the ‘lcd.cpp’  to change from using the ‘rgb_lcd’ driver to using the malpartida I2C or similar driver. https://github.com/grahamwhaley/DSPham/blob/master/lcd.cpp

Graham

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

kabidey, 2022-12-26:
I tried, but could not do it. So I ordered a grove LCD ;)

On Sun, Dec 25, 2022 at 1:23 AM Graham Whaley ***@***.***>
wrote:

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

grahamwhaley, 2022-12-26:
OK @kabidey, thanks for letting me know. Shall we close this Issue now, and you can open a new one if you get stuck with the new display?

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

kabidey, 2022-12-27:
Sure, thanks

On Tue, Dec 27, 2022, 4:29 AM Graham Whaley ***@***.***>
wrote:

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

Closed 2022-12-27.

Thread 27 (2023-06-07):

Voice Squelch [FEATURE]

Roturbo, 2023-06-07:
Hello Graham,

some time ago we have talk about a voice squelch, and now i see some code about it,
but i don´t know how to make it work with DSPham.

https://github.com/ramdor/Thetis-2.9.0/issues/113

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

There is also one link for the code, if you have some time check it please.

Regards

.

grahamwhaley, 2023-06-07:
Hi @Roturbo , nice to hear from you :-)

Thanks for the references and links. That looks like interesting code. A lot of the code from WDSP is interesting.
It is unlikely I will find time to integrate the code into DSPham though - I've not been actively developing DSPham. There are a few reasons for that:

- I'm not using my DSPham as much as I used to, as I'm mostly using some different radios now (which either have their own NR, or don't require it as much).
- I am almost purely a CW (morse code) person, so the NR functionality is less useful for me than say for SSB use. Back when I built DSPham I was doing a lot of listening to the bands, including quite a lot of SSB. Not so much now.

I am however still here and available to give input, guidance, review and ideas - I just might not have the time to write or integrate new code.

If you, or somebody else, does decide to integrate the squelch, I'd still recommend reading thread #23 (for instance https://github.com/grahamwhaley/DSPham/issues/23#issuecomment-1119428653) for some thoughts on how and where to integrate the code. There will be two major things to consider:

- where to put the code in the 'audio pipeline'
- how to control the code from the interface - which buttons and menu items for instance

btw, thanks for the nudge to re-visit WDSP - it made me realise that I had only integrated one of the NR features of WDSP (NR[1] - xanr), and completely missed there is an NR2 (emnr/spectral) method in there as well. I have opened a new issue #28 here to make a note of that! But, again, I cannot predict if I will get to trying it anytime.

Roturbo, 2023-06-13:
Hello @grahamwhaley , Thetis already have the voice squelch working,
take a look at the next video,, now the silence is always present if no
one is talking, just one ON/OFF, a slider to adjust and 2 items on menu,
timing for Mute and un-Mute.

https://youtu.be/U8etLJhfmAw

Regards

Thread 30 (2025-02-08):

NaN appears when changing volume menu item

grahamwhaley, 2025-02-08:
It has been reported, and I think I have seen, that changing the sgtl5000 headphone volume via the Volume menu item can show a 'NaN' error (Not-a-Number), which can then hang up and require a reboot.

I think this happens due to some sort of 'race'/sequence issue when first starting up with a blank eeprom. I have a feeling we then boot and load the default values into the RAM based settings, but then still try to load the volume setting from the eeprom, probably thus loading 0xffffffff into a float value, which then comes out as a NaN.

The quick fix is to do a 'factory reset' from the menu system. This then writes the default values to the eeprom, and from then on the volume value loading should work and the NaN problem 'goes away'.

The proper solution is either to:
  - not load the volume value from the eeprom if the eeprom does not contain valid data (bad eeprom signature)
  - potentially, write the default values to the eeprom on startup if no valid eeprom signature is found. This is a little destructive though, and may require a menu prompt to ask the user if they want the eeprom initialised, which might be a little tricky to code up.

W7STF, 2025-02-08:
I'd have to experiment a little here, but the solution could be even more simple than the two alternatives suggested.

I presume people building this project would want to either use the line-out of the Teensy Audio Adapter Board and run that to some tiny amplification circuit to either drive a local speaker or a speaker out jack -or- possibly use the headphones.

If the former, the HdVol parameter setting doesn't matter because it doesn't affect line out from the adapter board. In that case there is no need for persistence for that value.

If the latter, I don't see a real inconvenience by always defaulting the Headphone Volume to 0.0 on controller boot.

Thread 31 (2025-02-16):

PCF8574 I2C adapter driven 16x2 LCD needs additional logic to turn backlight on

W7STF, 2025-02-16:
Found when attempting to apply the Robaol patches to the original code for a non-RGB display, 16x2 I2C LCD attached to a PCF8574 adapter, specifically this white on blue LCD from Amazon:
https://www.amazon.com/dp/B0BWTFN9WF?ref=ppx_yo2ov_dt_b_fed_asin_title&th=1

The backlight was not energized, so added the following in DSPham.ino

In DSPham.ino:
load_colour();    //load lcd screen colour.

  //stf mod 2/16/2025 turn the backlight of the display I'm using on
  #ifdef USE_MATHERTEL_LCD
  lcd.setBacklight(HIGH);
  #endif

  morseInit()

Also noted that in the file lcd.h, for a 16x2 display, had to change the defines for LCD_ROWS and LCD_COLS from 4 and 20, to 2 and 16 respectively:
#ifdef USE_MATHERTEL_LCD
#include "LiquidCrystal_PCF8574.h"
#define LcdType LiquidCrystal_PCF8574
#define LCD_ROWS  (2)     //stf if the display had 4 rows of 20 characters these would be 4 and 20 respectively
#define LCD_COLS  (16)
#endif

grahamwhaley, 2025-02-17:
fyi @robaol - @W7STF is using your patches referenced in #29  whilst building a DSPham with a 2x16 display :-) Noting here to get cross references between the issues.
