grahamwhaley/DSPham/menu.h

// Example take from https://github.com/neu-rah/ArduinoMenu/
// Original license LGPL 2.1+

extern void menu_setup(void);
// returns true if menu is active
extern bool menu_poll(void);
extern void updateAGC();
