grahamwhaley/DSPham/(commit log)

2021-02-16 filters: normalise filter coeffs to 'unity' gain
    I've noticed that the dynamic FIR filter coefficients end up
    with a lot of attenuation at the center frequency. I think it's
    just a consequence of using fast dynamic filter coeff generation,
    rather than the long winded and processor intense 'optimal'
    calculations (if we do an online coeff calculation and inject those
    coeffs into a static table then we do see good non-attenuating
    performance).
    This impact the processing chain - as the filters come very early
    in the chain they basically reduce our 'data width' a lot, which must
    hurt some of the later algorithms.
    Try to 'normalise' the filters, by assessing their performance at their
    chosen cen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
2021-02-16 decimation: decimate the audio path by 4
    Decimate the audio path for processing down from the raw
    44kHz to 11kHz. The main goal here is not to reduce the processing
    overheads (although it does drop a 'full' SSB NR compute from 20%
    down to 7%), but is to allow the noise reductions that use 'bins' to
    focus those bins on the audio spectrom (0-5.5kHz), rather than spread
    them across the full CD quality bandwidth (0-24kHz). We *could* have
    bumped the number of bins in the NR systems (from 128 iirc) to get the
    same effect maybe, but then that would have cost us more CPU time for
    the same gain??
    The change seems to help. Now we need to see if it helps when combined
    with the FIR bandpass normalisat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
    [DSPham.ino, global.h]
2021-02-16 README: version: Update README and version -> v1.1
    Update the README to note we have moved to decimating the audio path.
    Also bump the version, as this is quite a large change.
    Add a version history table to help track changes.
2021-02-21 README: build: Note zip will have bad dir name
    GitHub 'usefully' post-pends the 'release' name to the directory
    it creates in its zip and tar.gz files, which is not what we want
    for an Arduino IDE project, as it will then likely fail to load
    or build. Make a note of this in the development section.
2021-02-21 README: elaborate schematic details
    Add some details around:
    - choosing an LCD display
    - calculating the LED drop resitor
2021-02-21 README: Note VIN/VUSB mod to board
    Note you need to snip a track on the Teensy 4.0 if you are going to use
    an external power supply (VIN) and the USB (VUSB) - or you may fry
    something.
2021-02-26 README: Add details around hardware choices
    Detail what you need to wire up, and edits/choices you may need to
    make if you use a different LCD or encoder.
2021-02-26 samples: Add some example sample files
    Add a couple of example/sample files to give an idea of potential
    performance.
    - a 5MHz weather broadcast with some rtty infringing
    - a 14MHz SSB with a constant high pitched whistle
2021-02-28 schematic: fix wrong I2C bus wiring
    Oops, the schematic had the LCD wired to the second (xxx1) I2C bus, but
    actually it should be wired to the first (xxx0) - shared with the audio
    board - as that is the 'default' arduino I2C bus for the Teensy 4.0.
    Whislt editing the schematic, also add a warning about using external
    PSU and plugging in USB - you need to snip a track on the Teensy. See
    the Teensy docs for more details.
2021-02-28 schematic: clarify rotary encoder module
    The rotary encoder I used was a module, that includes some pullups.
    Clarify the schematic around that area to make it clearer:
    - how to wire up the module if you are using one
    - what the module provides, and thus help define how to wire up
    a 'naked' module
2021-03-02 README: more click encoder clarification.
    Clarify the detent/steps of the encoder I used, and which bits of
    code you might need to modify if you use a different one.
    Clean up a bit of encoder text, as we do now show the module and
    pullups and +ve wiring on the schematic.
2021-03-15 FIR: clipping: Fix FIR filters. Add clipping indicator
    When adding the 'FIR filter normalisation' for v1.2, it looks like
    I messed up, and made things worse. The primary 'visible' results
    from this were:
    - it was very easy to clip the input audio levels, which then gave a
    nasty output
    - the morse decoders were struggling a lot more detecting tones.
    The core issue was some mismash of inherited code that meant we ended
    up with two notions of 'SAMPLE_RATE', and the wrong one (an index,
    not a value) ended up being used for the FIR evaluation, thus
    breaking it. Fix that by ensuring we now only have one idea of
    SAMPLE_RATE.
    Whilst there, it seemed obvious that we already measured the input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
    [DSPham.ino, dynamicFilters.cpp, global.cpp, global.h, lcd.cpp, menu.cpp, nr_kim.cpp, spectral.cpp]
2021-11-08 k4icy: enable decode '='
    The decoding of '-...-', '=' was commented out in the original code.
    But, the 2x16 LCD char map has an '=' sign available, so re-instate
    the code. And, I was getting bored of hearing '=' on the air and
    seeing it not be decoded!
    Fixes: #20
    [k4icy.cpp]
2021-11-08 k4icy decoder: improve 'failed to decode' char
    We had set the 'failed to decode' char to a '?', but of course
    that is a valid char, so is not actually that nice on the screen.
    Looking at the 2x16 char map, the 'solid block' char of 0xff is
    a better thing to draw - more obvious it is a 'failed decode'.
    [k4icy.cpp]
2021-11-08 cw: do not update tuning 'indicator' when in menu
    We constantly assess and update the CW 'tuning' indicator
    (<< < x > >>) when in a CW mode. This constantly calls the
    lcd.createChar() function, which was corrupting the lcd
    cursor position whilst in the menu system. This made it
    difficult to enter slot names for instance. This is
    'correct' behaviour from the LCD library, as creating a
    char in CGRAM has to update the address counter (AC), to
    write the CGRAM, which is the same AC that is used to draw
    the cursor position.
    Fix by never creating a char whilst the menu is active.
    Fixes: #7
    [DSPham.ino]
2021-11-08 settings: name field: stylistic cleanups
    There was a report that saving the name into a slot did not work. Having
    re-examined the code, although it was not obvious how it worked, it should
    have been working, and worked in my tests. The code could do with some minor
    fixups though, such as not hard coding the field length of '4' - as at least
    one user has modified their code to make the name fields longer, and some
    of the code may not have handled that well.
    [settings.cpp, settings.h]
2021-11-08 menu: name slot: add space as a valid name character
    The name slot menu setup only allowed you to choose from the
    letters a-z (only lower case), and digits 0-9. As the default
    new slot name comes up as '0x00' when you first go to set its
    name, that meant you would have to set all four characters,
    whether you liked it or not. Add a ' ' (space) as a valid char
    so you can now blank out un-used characters.
    Note, I've reviewed the fact that we only allow lower case
    chars in the name edit, and I think that is fine. It does
    reduce the amount of scrolling you have to do, and helps
    clarify default slots (which commonly have capitals) from
    user created slots.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
2021-11-08 version: bump version to v1.3
    Enough little changes and fixes to warrant a version change:
    c5afb48 k4icy: enable decode '='
    a7fc498 k4icy decoder: improve 'failed to decode' char
    a2c344d cw: do not update tuning 'indicator' when in menu
    bfdb572 settings: name field: stylistic cleanups
    dbceabd menu: name slot: add space as a valid name character
    [global.h]
2021-11-10 settings: enable setting of last NR mode
    Due to a >= rather than a >, it was not able to set the
    NR mode of a slot to the last NR mode type - LLMS. This
    took a bit of figuring out, as I just happened to be
    testing with the NR_MAX entry. Other entries worked!
