grahamwhaley/DSPham/(notices)

Notices in the files:
tf3lj.h:
Copyright (c) 2016 Loftur E. Jonasson (tf3lj [at] arrl [dot] net)
This program is free software: you can redistribute it and/or modify
it under the terms of the GNU General Public License as published by
the Free Software Foundation, either version 3 of the License, or
(at your option) any later version.
The GNU General Public License is available at
